sinara-hw/SiLPA_HL/README.md

# SiLPA

Simple Low distortion Power Amplifier

## Design Files

Design files (schematics, PCB layouts, BOMs) can be found at [SiLPA/Releases](https://github.com/sinara-hw/SiLPA/releases).

## Wiki

More information can be found on the [wiki](https://github.com/sinara-hw/SiLPA/wiki).
