sinara-hw/SiLPA_HL/(list of files, drawings)

Other design files:
Panel/Panel_SiLPA.PcbDoc
PCB/SiLPA.PrjPCB
PCB/SiLPA.schdoc
PCB/SiLPA_CPCIS_Con_P1_P6.SchDoc
PCB/SiLPA_LVDS_IFC.SchDoc
PCB/SiLPA_MCU.SchDoc
PCB/SiLPA_PWR_Supply.SchDoc
PCB/SiLPA_RF_channel.SchDoc
PCB/SiLPA_RF_channel_preamp.SchDoc
PCB/SiLPA_RF_detector.SchDoc
PCB/Urukul/Urukul.PcbLib
PCB/Urukul/Urukul.SCHLIB
