sinara-hw/SiLPA_HL/(threads)

Thread 1 (2021-05-12):

[RFC] simple power amplifier

jordens, 2021-05-12:
We have an AOM power amplifier application where [Booster](https://github.com/sinara-hw/Booster/wiki) appears overkill (manufacturing/mechanics, complexity, number of channels, output power, bandwidth, gain, size, weight, cost). We are exploring alternative ideas and need:

* P1dB: 30 dBm min, 33 dBm target
* gain (over the bandwidth): 24 dB (10 dBm from Urukul with amp) or 40 dB (-7 dBm from Pounder, 0 dB ? from Phaser, Mirny)
* bandwidth: 40-350 MHz (10-450 MHz if possible, or talk about e.g. 80 MHz+-10 MHz narrowband if it dramatically simplifies the design)
* if this is a two-stage amplifier with a preamp, consider two preamp gain variants to cover both Urukul/Mirny/Pounder and Phaser input power.
* channel crosstalk: as good/bad as Urukul
* 3U form factor, maybe 4 HP, maybe 2 channels per board, SMA-to-SMA
* if possible no fan, no moving parts, convective cooling
* power 12 V or as convenient
* O/IIP2 doesn't matter
* OIP3 50 dBm target
* fast output reflection interlock (only if that design is risk-free), manual front-panel reset + LED and ~10 min automatic reset if that can be made safe and robust.
* LEDs for interlock, power good, over temp
* optional: a µC on board for calibration, monitoring, USB/UART/I2C

Potential USPs:

* no complicated sequencing
* no additional negative voltages for amplifier
* fewer amplification stages
* simpler integrated biasing
* smaller than a Booster channel
* lower minimal space usage
* Simpler mechanics, simpler shielding, simpler assembly and disassembly, no internal pigtails
* higher efficiency at its P1dB
* less gain, better matched to Urukul/Mirny
* no moving parts, no fans
* lower cost per channel
* fewer bugs/higher robustness from the start

Acceptable trade-offs:

* higher temp co
* 6 dB lower P1dB
* potentially less gain (important for Phaser)
* potentially lower bandwidth
* potentially higher crosstalk
* no monitoring, calibration, logging
* no remote control
* no remote interlock clear

Questions:

* Would this be a significant simplification w.r.t. Booster or would it meet the same challenges?
* Are there other interested users and use cases?
* Is there something missing or too much to make this both different from Booster and decidedly useful for applications?

gkasprow, 2021-05-12:
This is the initial component placement.
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
My student will make an MWO model, write initial SW and perform tests.

Thread 5 (2023-04-25):

IC18 Reference Voltage for MAX1329 is damaged

tprzywoz, 2023-04-25:
On my test board IC18 output is ~0.5 V (even with R85 and R86 removed). Probably it's because MAX1329 receives VREF before configuring the AVDD  (default state of MAX's Internal Charge Pump is OFF)

gkasprow, 2023-04-25:
we need to route AVDD to SHDN of reference source

tprzywoz, 2023-04-25:
Just remember that AVDD is about 4 V.

skuchars, 2024-03-10:
From ADR391 datasheet:
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
I assume we will use first option?
Regarding @tprzywoz last note - there is no specified maximum voltage for Shutdown Logic High and minimum is 2.4 V, and V_IN can range from 2.8 V to 15 V, so I think 4 V will be ok.

skuchars, 2024-03-27:
@gkasprow

gkasprow, 2024-03-27:
4V is OK, it,s within the supply range

skuchars, 2024-05-25:
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

gkasprow, 2025-02-20:
@skuchars pls update the design ASAP, we need it to make SILPA_HE version

Thread 8 (2023-05-05):

SERVMOD

tprzywoz, 2023-05-05:
According to DIOT_system_specification_v2.0 servmod should be driven high to attach EEPROM to the shared I2C bus (currently system board has to drive low because of T18).

Second issue is lack of pull down resistor.

kaolpr, 2024-02-08:
Before implementing compare with EEM FMC Carrier and DIOT FMC Carrier.

skuchars, 2024-03-10:
@tprzywoz is right, DIOT_system_specification_v2.0 says:
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
Pull down resistor - in DIOT system specification there is one
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
but in the EEM FMC Carrier there isn't.
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
How do we want here?

gkasprow, 2024-03-10:
There is a bug in the EEM FMC Carrier. Use 220R resistor here

skuchars, 2024-05-25:
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

Thread 10 (2023-11-06):

P3V3_MP decoupling

jmatyas, 2023-11-06:
At the moment there is no safety or decoupling mechanism between P3V3_MP produced on board by IC33 from 12 V and the one provided by EEM connector, so P3V3_MP net is driven by two power sources.

kaolpr, 2024-02-08:
Maybe we could give a diode between actual P3V3_MP net and IC33 output as it is done in Stabilizer:
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

skuchars, 2024-05-25:
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

Thread 11 (2023-11-06):

PGOOD LED not working

jmatyas, 2023-11-06:
Both IC5 ([TPS62148](https://www.ti.com/lit/ds/symlink/tps62148.pdf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)) and IC29 ([LTC3624](https://www.analog.com/media/en/technical-documentation/data-sheets/36242fd.pdf)) voltage converters Power Good output pins are open drain.

PGOOD LED is turned on by the transistor which gate is driven by PGOOD pin, so it won't work without an external pull-up resistor

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

skuchars, 2024-05-25:
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

gkasprow, 2024-05-28:
we need pullup on the T5 gate

skuchars, 2024-05-28:
Right, of course, my mistake.
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

Thread 9 (2023-11-06):

Wrong LD14 and TP label

jmatyas, 2023-11-06:
LD14 is mislabeled on the PCB - the label says it's LED and TP for P5V0, when in reality it is for P3V3:

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

Thread 13 (2023-11-15):

Comparator input pins swapped

jmatyas, 2023-11-15:
Comparator circuit with IC10 is designed as a non-inverting comparator.  This setup,  together with IC11 flip-flop, works as a minimal power limiter. It should be used as an inverting comparator, so the OP-AMP's output is driven LOW (disables output power), when RF_VRMS voltage exceeds threshold voltage.

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

skuchars, 2024-05-25:
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

Thread 14 (2023-12-14):

Wrong pins assigned to I2C2

jmatyas, 2023-12-14:
Currently I2C2 pins are assigned to PB12 (as SDA) and PB13 (as SCL).

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

According to STM32 DS9826 I2C2 is available on pins PB13 (as SCL - no problem here) and PB14 as SDA.
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

skuchars, 2024-05-25:
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

Thread 15 (2023-12-14):

I2C1: no pull-ups

jmatyas, 2023-12-14:
There are no pull-up resistors for I2C1 bus, and while it is OK when working with external controller (such as Kasli), it may be problematic when working in a standalone mode.

kaolpr, 2024-02-08:
IS or MAY be a problem?

Note that in Sinara pull-ups are present on controller, so adding another on peripheral may lead to problems. Let's first identify if we really need those.

Thread 16 (2023-12-22):

USB data pins swapped

jmatyas, 2023-12-22:
According to Stm32F07 datasheet and reference manual it supports USB Full-Speed interface. But the pins are swapped:

Silpa schematics:

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

vs STM datasheet:

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

And it's not only "labeling" issue - host PC detects Silpa as a low-speed USB device (which means that it finds a pull-up resistor on DM line instead of DP)

skuchars, 2024-05-25:
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

Thread 17 (2023-12-22):

Better control over interlocks

jmatyas, 2023-12-22:
Currently it is possible to disable interlocks directly only by the means of setting power threshold to a specific value or forcing over-temperature shutdown.  Please add a way for both MCU and an external controller to force disabling RF channel (preferably each channel independently).

And while an external controller is able to read the channel's state, MCU has now way of doing that. Please add a way for the MCU to read the channel's state.

kaolpr, 2024-02-08:
How it is implemented in Booster? I know that there is a setting exposed via MQTT that can make channel enabled or disabled, but don't know how it is implemented.

Anyway, channel state information in MCU should be available.

ndnq, 2024-02-12:
If we are talking about output power interlocks, in Booster they too can only be "disabled" by writing a high enough threshold value. Other interlocks are hardcoded and cannot be turned off.

As for reading the RF channel's current state, Booster posts it over MQTT as part of telemetry data. The fastest it can do so is I think every second. For what I've been doing with it, it has been sufficient.

You can also post or read the state from the settings interface over MQTT. Posting to it can disable the RF output or completely power down the channel depending on the sent payload, and that's what I have been doing.
Reading from it, on the other hand, makes little sense as it will repost the state that it was set to and not the current one.

jmatyas, 2024-02-13:
I think there was a misunderstanding. What I actually meant by saying "disabling interlocks" was to disable RF channel. Sorry.

Booster hardware provides a means of turning RF channel in at least two ways other than setting interlock threshold low enough. CPU can either:
  *  drive SIG_ON LOW to turn the safety switch (IC14 on preamp sheet ) OFF, which decouples input signal from the amplifiers, or
  * disabling power fed to the RF channel.
 However, the two solutions usually are used together.

On Silpa there is no such possibility so it would be nice to add these functionalities (together with **channel state**). It shouldn't be a pin-availability problem, since there are plenty unused - we don't need 2 serial ports (USART1 AND USART3) AND USB communication. Additionally, we don't use ADL5904 as the threshold detection device, so we could free both VCAL pins as well.

gkasprow, 2025-01-13:
Actually, we will keepe USB control (stand-alone application). We can keep  UART3 for debug purposes but UART1 is not needed. One can add an AND gate at the output of the OR gate and control it from MCU

Thread 18 (2023-12-22):

Change user interface

jmatyas, 2023-12-22:
Please adjust front panel user interface to resemble the one on Booster (in terms of usage and functionality).

 * a physical button on front panel to disable both channels would be a nice feature to have;
  * same goes for DFU button;
  * consider moving PWR, PG, and bias LEDs to the board, as they convey mostly debugging information;

Photo copied from Booster firmware [docs](https://quartiq.de/booster/front-panel.html):

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

Thread 19 (2023-12-22):

LM75 thermometer placement

jmatyas, 2023-12-22:
Both LM75 thermometers are separated from RF channels and power amplifiers by radiator. Shouldn't they be placed just around the main heating element (or on the other side of the board with some kind of thermal connection to the element)?

Correct me if I'm wrong, but the way they are placed now, their measurements are meaningless - the temperature outside of the radiator is of a given value and provides no reliable way of knowing what temperature is around power amplifiers. Or am I missing something?

Thread 21 (2024-01-04):

RF channel characteristics

jmatyas, 2024-01-04:
I did some measurement work on Silpa and its RF signal path and here are the results.

## AM/AM measurements
Measurements were performed using a signal generator and a spectrum analyzer. A continuous wave single tone signal at 200 MHz from the signal generator was fed to Silpa channel's input. Channel's output was connected to the spectrum analyzer's input. For each input power value, a number of measurements was taken and their average value was used for processing. The procedure was repeated 4 times - for each of the Qorvo amplifier bias settings. Presented below are results for the most linear bias setting.

This allowed to obtain the following RF channel parameters:
  * fixed Gain of around 52 dB
  * P1dB of around -19 dBm (@gkasprow  **is this OK?** considering it's supposed to work together with Urukul, which nominal max output power is 10 dBm)
  * Output power at P1dB of around 32 dBm

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

## Frequency analysis
Frequency analysis was performed using spectrum analyzer with its built in tracking generator. Tracking generator's output was set to -20 dBm and connected to Silpa channel's input via 20 dB attenuator so the signal was in Silpa's linear region. Analysed frequency range was between 5 MHz and 2.005 GHz. Presented results are for the most linear bias setting. Cutoff frequencies were defined as points were the power gain drops by 3 dB.

RF channel frequency parameters:
  * maximum gain of 53.3 dB at around 40 MHz
  * lower cutoff frequency at 12 MHz
  * upper cutoff frequency at 385 MHz (@gkasprow  **is this OK?** considering it's supposed to work together with Urukul, which output frequency is > 400 MHz)

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

gkasprow, 2024-01-04:
The gain is too high.
I'd opt for 40 dB.
The way you define cutoff frequency depends on reference. If you define +/- 3dB, it would be much higher.
The SilPA HL is intended to work with Phaser.
We will create an HE version of it that is suitable for Urukul.
We don't want to operate Phaser/Urukul with max power due to distortions.
I expected 2W of output power with low distortions, at least such were my measurements of the power stage.
Please measure with RF probe (1k resistor in series with coax cable) where the compression occurs. I'm not sure if it is the power stage. Silpa HL is intended for low harmonic operations, so we are more interested in second/third harmonic distortion than bandwidth or P1dB.
We probably need to linearise the previous stages and lower the R3 value, which will reduce gain and improve linearity.
I'd add feedback to ADL5536 or replace it with lower-gain chip

skuchars, 2025-07-03:
added attenuation pads
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

Thread 22 (2024-02-08):

Ongoing release - v1.1

kaolpr, 2024-02-08:
@skuchars will be implementing fixes and improvements included in v1.1 milestone. If anyone has any suggestions or requests now is a final call.

shanasz, 2025-03-21:
@skuchars when do You plan to push next commit? I need it for work on HE version.

skuchars, 2025-03-23:
I've just made a commit.

martafafara, 2025-05-12:
@gkasprow Do you know anything about progress?

gkasprow, 2025-05-12:
I think the  design needs review

martafafara, 2025-05-13:
Currenctly the design has unconnected nets, so layout still may change. I'm rather excepting some closed version

gkasprow, 2025-05-13:
All is fine, those are copper balancing polygon and need to be added to the design rules as an Unrouted net

martafafara, 2025-05-13:
I don't find traces in the pictures below  as the part of copper balancing.

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

Additionally, the schematics are not consistent with PCB. Probably that is the reason why some issues implemented in schematic are not closed yet.

gkasprow, 2025-05-13:
are you looking at devel 1.1branch?

gkasprow, 2025-05-13:
but still schematic is not in sync @skuchars

martafafara, 2025-05-13:
Yes, 1.1 branch with latest update 2 months ago. The main branch is closed

Thread 24 (2024-02-08):

Schematic review - v1.1

kaolpr, 2024-02-08:
Use this issue for small corrections required for schematics. List them as tasks list. If a more complex problem is noticed feel free to create a new issue.

skuchars, 2024-03-10:
- [ ] #2 - it has already been done in first version, now I only organized schematic SiLPA_CPCIS_Con_P1_P6
- [ ] #5
- [ ] #6
- [ ] #7 - these capacitors were placed wrongly on board, but they exist on schematic, so that is only a layout issue
- [ ] #8
- [ ] #10 - added diode as @kaolpr suggested
- [ ] #11
- [ ] #12

skuchars, 2024-03-18:
- [ ] #13
- [ ] #14
- [ ] #16
- [ ] #17
- [ ] #18
- [ ] #20
- [ ] #21
- [ ] #26

skuchars, 2024-05-06:
- [ ] #28
- [ ] #29

skuchars, 2024-05-25:
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

gkasprow, 2024-08-26:
@skuchars whare are you with layout?

skuchars, 2024-10-22:
I have been doing it bit by bit for some time, but I can maximize effort now so hopefully I could finish most of the issues in few days time; then I will make a commit. But still any of my schematic changes weren't actually approved so it would be great if that can happen soon, for example by @kaolpr.

skuchars, 2024-11-03:
@gkasprow

gkasprow, 2024-11-03:
pls make sure you follow the newest DIOT template
https://github.com/sinara-hw/DIOT-Template/issues/1

skuchars, 2024-11-16:
Questions:
1. In sequencing circuit posted in https://github.com/sinara-hw/meta/issues/91#issuecomment-2302802191 there are absent transistors T3 and T4, but they do appear in the newest DIOT template. Which version should I implement, probably the newer one?
2. In LVDS schematic IC32 is fully used (all sub-parts, A-D), was this intentional or I can drop this design and copy new DIOT template (only A B sub-parts in use)?

gkasprow, 2024-11-23:
1. yes
2. it's better to use all parts, this lowers RDSon

gkasprow, 2024-11-23:
2. I fixed that in the template

martafafara, 2025-04-24:
- [ ] #3

martafafara, 2025-05-21:
- [ ] LD7 current is limited only by T5 RDSon
- [ ] IC39 is obsolete (replacement: TLC55IDR)
- [ ] The O-ring connection at P3V3MP - used diodes could lead to power losses. Maybe ideal diode instead?
- [ ] No variants for EEM and DIOT as requiered in [DIOT Template](https://github.com/sinara-hw/DIOT-Template/issues/1)
- [ ] 3 fiducials per site is more convinient
- [ ] schematic sheets need to be numbered
- [ ] IC26 and IC27 are obsolete
- [ ] take into account #3

skuchars, 2025-07-03:
IC39 TLC55ID -> TLC55IDR
IC26, IC27 LM75AIMM/NOPB -> LM75AIMMX/NOPB

@martafafara can you elaborate point 4, about P3V3MP? Because I'm not sure I understand it correctly, do you want to change D5?

skuchars, 2025-07-10:
Thank you for your explanation. I propose LM66100DCKR, it fits our parameters (1.5V to 5.5V VDD, up to 1.5A), it's readily available (Mouser has 17k of them in stock currently), small and easy to replace if needed (SC70-6 package).

martafafara, 2025-07-11:
It seems to be appropriate solution. Waiting for new commit.

martafafara, 2025-09-30:
- [ ] According to LM66100DCKR - ST pin should rather be pulled up to VOUT than short-circuited to the ground. It's the output pin that could generate unnecessary EMI problems.
- [ ] No variatns are predicted

@skuchars May I start with layout review?

Thread 25 (2024-02-08):

Layout review - v1.1

kaolpr, 2024-02-08:
Use this issue for small corrections required for layout. List them as tasks list. If a more complex problem is noticed feel free to create a new issue.

martafafara, 2025-10-01:
@skuchars there are issues corresponding to PCB layout that are not introduced yet.

Include DIOT-Template PCB recommendation - shape, origin etc.

Thread 26 (2024-02-08):

SMA connectors

kaolpr, 2024-02-08:
Please change 132203-14 to Delock 65848.

skuchars, 2024-03-24:
Are you sure @kaolpr? Because I can't find any reliable distributor of these connectors - Mosuer, TME or Octopart don't have them. I've found only https://www.reichelt.com/pl/en/sma-jack-90-pcb-delock-65848-p259393.html but I don't know if this website is ok. Maybe @gkasprow will know something?

gkasprow, 2024-03-24:
We buy these connectors in high quantities from Reichelt.

gkasprow, 2024-03-24:
We use them in entire SInara family, copy them from Urukul

Thread 28 (2024-04-19):

Disconnect GND from output track

marmeladapk, 2024-04-19:

skuchars, 2024-05-06:
Do you mean to disconnect output SMA connectors J4 and J6 from GND? If so, what about inputs J3 and J5, disconnect them too?
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

gkasprow, 2024-05-06:
why would you want to disconnect RF ground?

marmeladapk, 2024-05-09:
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
 GND in these bridges should be cut.

Thread 29 (2024-04-19):

Output amplifier has 75 ohm not 50 char. impedance

marmeladapk, 2024-04-19:

skuchars, 2024-05-06:
Ok, so can we just change baluns from TRS1.5-182+ to something that will transform the impedance?

skuchars, 2024-05-18:
@marmeladapk

marmeladapk, 2024-05-21:
Yes, from 75 to 50.

skuchars, 2024-12-11:
I used TCM1-63AX+, but we can use any of the TCM1- 43X+/63AX+/83X+/382WX+, they all are K configuration and have the same footprint DB1627.

Thread 30 (2024-05-10):

Missing copper polygons on bottom layer

sebmalinowski, 2024-05-10:
On bottom layer under IC7A and IC7B copper polygons are missing. They should be added for better thermal conductivity in order to cool these amplifiers more efficently.

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
