sinara-hw/SiLPA_HL/SW/SW.ioc

Mcu.UserName=STM32F078RBTx
PA0.Signal=ADC_IN0
PA1.Signal=ADC_IN1
PA10.Signal=USART1_RX
PA11.Signal=USB_DM
PA12.Signal=USB_DP
PA13.Signal=SYS_SWDIO
PA14.Signal=SYS_SWCLK
PA15.Signal=SPI1_NSS
PA2.Signal=ADC_IN2
PA3.Signal=ADC_IN3
PA4.Signal=COMP_DAC1_group
PA5.Signal=COMP_DAC2_group
PA6.Signal=ADC_IN6
PA7.Signal=ADC_IN7
PA8.Signal=S_TIM1_CH1
PA9.Signal=S_TIM1_CH2
PB1.Signal=USART3_DE
PB10.Signal=SPI2_SCK
PB11.Signal=I2C2_SDA
PB12.Signal=SPI2_NSS
PB13.Signal=I2C2_SCL
PB3.Signal=SPI1_SCK
PB4.Signal=SPI1_MISO
PB5.Signal=SPI1_MOSI
PB6.Signal=USART1_TX
PB7.Signal=I2C1_SDA
PB8.Signal=I2C1_SCL
PC2.Signal=SPI2_MISO
PC3.Signal=SPI2_MOSI
PC4.Signal=USART3_TX
PC5.Signal=USART3_RX
PF0-OSC_IN.Signal=RCC_OSC_IN
PF1-OSC_OUT.Signal=RCC_OSC_OUT
