sinara-hw/SiLPA_HL/(commit log)

2021-05-12 initial schematics and PCB placement
    [SiLPA.PrjPCB, SiLPA.schdoc, SiLPA_LVDS_IFC.SchDoc, SiLPA_MCU.SchDoc, SiLPA_PWR_Supply.SchDoc, SiLPA_RF_channel.SchDoc, SiLPA_RF_channel_preamp.SchDoc, SiLPA_RF_detector.SchDoc]
2021-07-05 v1.0rc1 - schematics
    [SiLPA.PrjPCB, SiLPA.schdoc, SiLPA_LVDS_IFC.SchDoc, SiLPA_MCU.SchDoc, SiLPA_PWR_Supply.SchDoc, SiLPA_RF_channel.SchDoc, SiLPA_RF_channel_preamp.SchDoc, SiLPA_RF_detector.SchDoc]
2021-08-19 Initial RF-elements placement
    Initial RF-channel and RF-preamp elements placement obtained from AWR MWO.
    [Sheet1.PcbDoc]
2021-08-21 PCB 1.2
    Complete RF channel, preamp and detector.
    [Sheet.PcbDoc, SiLPA.PrjPCB, SiLPA.schdoc, SiLPA_RF_channel.SchDoc, SiLPA_RF_channel_preamp.SchDoc, SiLPA_RF_detector.SchDoc]
2021-08-22 added missing footprint; added impedance rule
2021-09-04 PCB v1.3
    [SiLPA.PrjPCB, SiLPA_RF_channel.SchDoc, SiLPA_RF_channel_preamp.SchDoc]
2021-09-05 added clearance rule
    [SiLPA.PrjPCB]
2021-09-07 PCB v1.3.1
    [SiLPA.PrjPCB, SiLPA_PWR_Supply.SchDoc, SiLPA_RF_channel_preamp.SchDoc, SiLPA_RF_detector.SchDoc]
2021-10-31 PCB v1.3.2
    [SiLPA.schdoc, SiLPA_LVDS_IFC.SchDoc, SiLPA_MCU.SchDoc, SiLPA_RF_channel.SchDoc, SiLPA_RF_channel_preamp.SchDoc]
2021-11-23 PCB v1.3.3
    [SiLPA.PrjPCB]
2021-12-04 PCB v1.3.4
    [SiLPA.schdoc]
2021-12-07 PCB v1.3.5
    [CPU.PcbDoc, Sheet.PcbDoc, Sheet1.PcbDoc, SiLPA_PWR_Supply.SchDoc, SiLPA_RF_detector.SchDoc]
2022-03-08 PCB 1.3.6
    Partly solved Booster issue #369
    [SiLPA.PrjPCB, SiLPA_RF_detector.SchDoc]
2022-04-01 PCB 1.3.7
    Solved Booster issue #369, added MAX3130 and variant STM32L100
    [SiLPA.PrjPCB, SiLPA_MCU.SchDoc, SiLPA_RF_detector.SchDoc]
2022-05-23 PCB 1.3.8
    [SiLPA.PrjPCB, SiLPA_MCU.SchDoc, SiLPA_PWR_Supply.SchDoc, SiLPA_RF_detector.SchDoc]
2022-07-29 PCB 1.3.9
    Added schematics for CPCIS.
    [SiLPA.PrjPCB, SiLPA.schdoc, SiLPA_CPCIS_Con_P1_P6.SchDoc]
2022-08-25 PCB 1.3.10
    CPCIS connectors placed on board.
    [EEM_FMC_Carrier.SCHLIB, SiLPA.PrjPCB, SiLPA.schdoc, SiLPA_CPCIS_Con_P1_P6.SchDoc, SiLPA_MCU.SchDoc, SiLPA_PWR_Supply.SchDoc]
2024-05-18 v1.1 - schematic review part 1
    Issues: #2 , #5, #7 , #8 , #10 , #11 , #12 , #13 , #14 , #16 , #20 , #26
    [SiLPA.PrjPCB, SiLPA.schdoc, SiLPA_CPCIS_Con_P1_P6.SchDoc, SiLPA_LVDS_IFC.SchDoc, SiLPA_MCU.SchDoc, SiLPA_PWR_Supply.SchDoc, SiLPA_RF_detector.SchDoc, Urukul.PcbLib]
